ersan-oz/jamiryo-desktop-buddy/hardware/stl/cover.stl

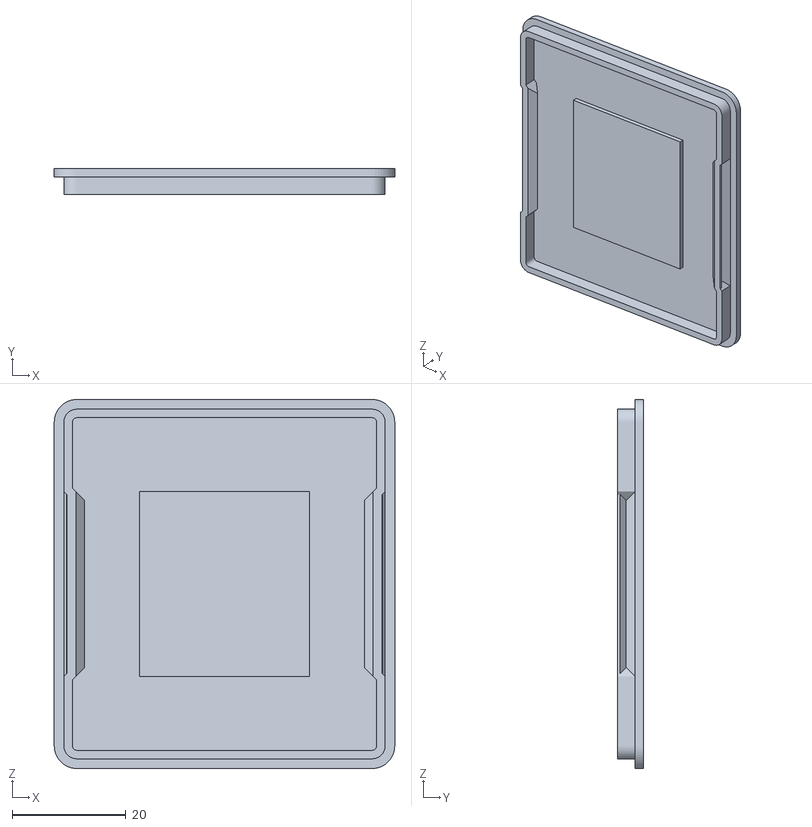
[picture p2: CAD file, 2026-10-27]
hardware/stl/cover.stl
60.0 x 4.50 x 65.0
