ersan-oz/jamiryo-desktop-buddy/hardware/stl/head.stl

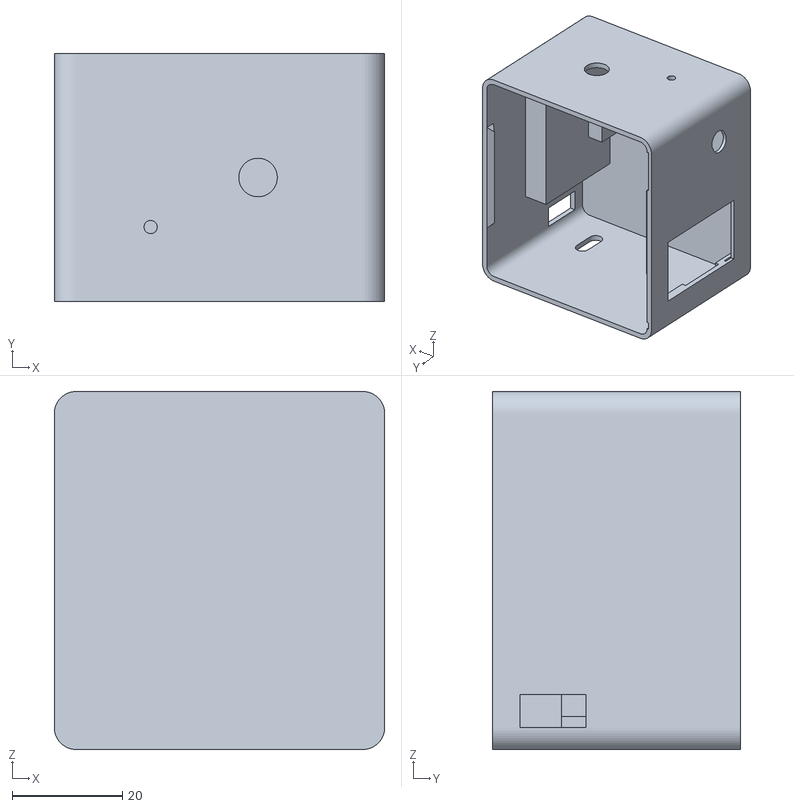
[picture p3: CAD file, 2026-10-27]
hardware/stl/head.stl
60.0 x 45.0 x 65.0
