ersan-oz/jamiryo-desktop-buddy/hardware/stl/base.stl

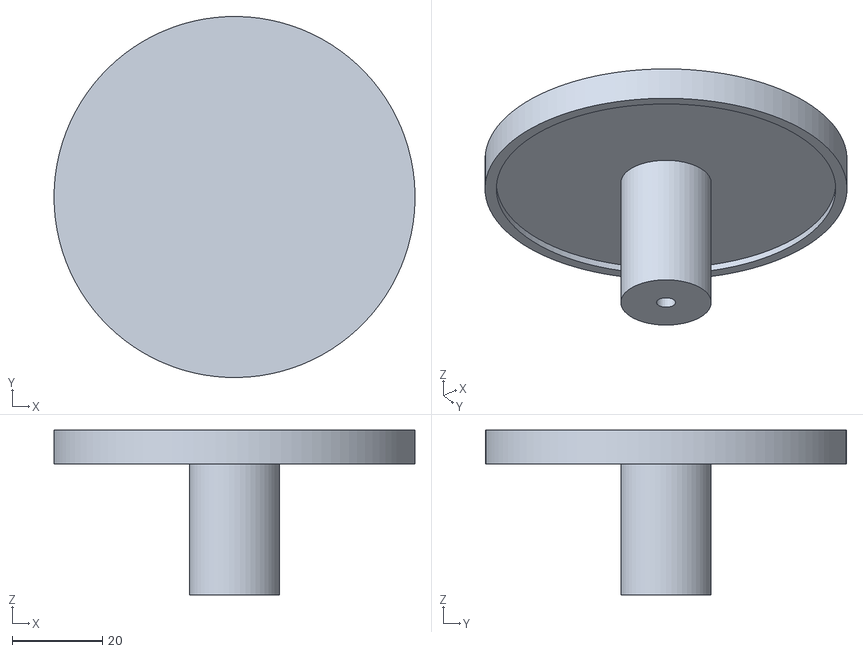
[picture p4: CAD file, 2026-10-27]
hardware/stl/base.stl
80.0 x 80.0 x 36.5
