ersan-oz/jamiryo-desktop-buddy/main/assets/home_setup.html

# Jamiryo · Ev seçimi

Kayıtlı bir evi seç veya yeni bir evin bağlantılarını kaydet. Her evin Wi-Fi, Home Assistant ve Gemini anahtarı ayrı saklanır. En fazla dört ev saklanır. Cihaz adları ve durumları Home Assistant’tan otomatik bulunur.

## Yazılım güncellemesi

Sürüm kontrol ediliyor…

Yeni yazılım dosyası Güncellemeyi yükle

Jamiryo için hazırlanan .bin dosyasını seç. Ev ayarların ve hafızan korunur.

Yükleme bitene kadar Jamiryo açık kalsın ve kurulum Wi-Fi’sinden ayrılma. Güncelleme sırasında konuşma ve kamera kısa süre durur.

## Kafa taraması ve hareket takibi

Takip Motor yönü Ayarları kaydet

Ayarlar okunuyor…

Açıkken açılışta yaklaşık 90° çevreyi tarayıp merkeze döner. Sonra uyanık ve sessizken görüntüdeki belirgin harekete yönelir. Kendi dönüşü ve ışık değişimi hedef sayılmaz. Kamera ile kafa birlikte dönmeli. İlk denemeyi servo yüksüzken yap; gerçek açı montajda kontrol edilir. Kafa senden uzaklaşıyorsa yönü ters çevir. Konuşma, fotoğraf ve uykuda hareket bekler. Ayarlar sonraki açılışlarda da korunur.

## Fotoğraflı bildirim

Seçili evin Home Assistant uygulamasına kayıtlı telefonunu seç. Tek telefon varsa ilk fotoğrafta otomatik seçilir.

Telefonları bulTelefonBu telefona gönder Jamiryo’ya “Fotoğraf çekip telefonuma gönder” de. Son çekim öncekinin yerini alır.

## Yeni ev ekle

Profil adı Wi-Fi adı · 2,4 GHz Wi-Fi şifresi Mevcut profili düzenlerken boş bırakırsan kayıtlı şifre korunur. Home Assistant adresi Home Assistant erişim anahtarı Home Assistant profilindeki Güvenlik → Uzun ömürlü erişim anahtarları bölümünden oluştur. Mevcut profili düzenlerken boş bırakırsan kayıtlı anahtar korunur. Gemini API anahtarı İnternete bağlıyken Google AI Studio → API Keys (https://aistudio.google.com/api-keys) sayfasından anahtar oluşturup buraya yapıştır. Ardından Jamiryo’nun kurulum Wi-Fi’sine geri dön. Her ev kendi anahtarını kullanır; mevcut profili düzenlerken boş bırakırsan o evin anahtarı korunur.

Yeni ev için Gemini API anahtarı gerekli. Kayıtlı anahtar ekranda gösterilmez.

Sesle kontrol edeceğin cihazları Home Assistant’ta Ayarlar → Sesli asistanlar → Kullanıma sun bölümünden Assist’e aç. Entity kimliği yazmana gerek yok. Jamiryo’ya cihazın adını veya odasını söyleyebilirsin.

Kaydet ve bu eve geçYeni ev formu

Ev profilleri yükleniyor…
