ersan-oz/jamiryo-desktop-buddy/(commit log)

2026-10-27 Add English project overview and public release metadata
    [partitions.csv]
2026-10-27 Add public source: main/sensors
2026-10-27 Add public source: main/servo
2026-10-27 Add public source: hardware/stl
    [base.stl, cover.stl, head.stl]
2026-10-27 Link printable enclosure parts from the project overview
2026-11-02 Document local motion attention and current usage
2026-11-02 Track localized movement independently of face matching
2026-11-02 Keep motion corrections running through microphone activity
    [head_motion.h, head_routine.h, head_servo.cpp, head_servo.h, motion_follow.h]
2026-11-02 Rename setup controls for camera motion attention
2026-11-02 Add direct head buttons to English HA setup
